Xinyuan-LilyGO/T-Display-S3-Pro-MVSRBoard/README.md

<!--
 * @Description: None
 * @Author: LILYGO_L
 * @Date: 2023-09-11 16:13:14
 * @LastEditTime: 2025-02-14 14:40:34
 * @License: GPL 3.0
-->
<h1 align = "center">T-Display-S3-Pro-MVSRBoard</h1>

## **English | [中文](./README_CN.md)**

## VersionIteration:
| Version | Update date |Update description|
| :---: | :---: |:---: |
| T-Display-S3-Pro-MVSRBoard_V1.0 | 2024-09-13 | Original version |
| T-Display-S3-Pro-MVSRBoard_V1.1 | 2024-12-03 | Replace microphone model |

## PurchaseLink

| Product | SOC |  FLASH  |  PSRAM | Link |
| :---: | :---: |:---: | :---: | :---: |
| T-Display-S3-Pro-MVSRBoard_V1.0 | NULL | NULL | NULL |  [NULL]() |

## Directory
- [Describe](#describe)
- [Preview](#preview)
- [Module](#module)
- [SoftwareDeployment](#SoftwareDeployment)
- [PinOverview](#pinoverview)
- [RelatedTests](#RelatedTests)
- [FAQ](#faq)
- [Project](#project)

## Describe

The T-Display-S3-Pro-MVSRBoard is the backplate design for the [T-Display-S3-Pro](https://github.com/Xinyuan-LilyGO/T-Display-S3-Pro) motherboard, featuring onboard speaker and microphone expansion with extremely low static current. Additionally, it includes vibration and RTC (Real-Time Clock) functions.

## Preview

### Actual Product Image

## Module

### 1. Speaker

* Chip: MAX98357A
* Bus communication protocol: IIS
* Other: Default using 9dB gain
* Related documentation: 
    >[MAX98357A](./information/MAX98357AETE+T.pdf)
* Dependent libraries: 
    >[Arduino_DriveBus-1.1.16]()

### 2. Microphone

> #### T-Display-S3-Pro-MVSRBoard_V1.0 version
> * Chip: MSM261S4030H0R
> * Bus communication protocol: IIS
> * Related documentation: 
>    >[MSM261S4030H0R](./information/MEMSensing-MSM261S4030H0R.pdf)
> * Dependent libraries: 
>     >[Arduino_DriveBus-1.1.16]()

> #### T-Display-S3-Pro-MVSRBoard_V1.1 version
> * Chip: MP34DT05-A
> * Bus communication protocol: PDM
> * Related documentation: 
>    >[MP34DT05-A](./information/mp34dt05-a.pdf)
> * Dependent libraries: 
>    >[Arduino_DriveBus-1.1.16]()

### 3. Vibration

* Bus communication protocol: PWM

### 4. RTC

* Chip: PCF85063ATL
* Bus communication protocol: IIC
* Related documentation: 
    >[PCF85063ATL](./information/PCF85063ATL-1,118.pdf)
* Dependent libraries: 
    >[Arduino_DriveBus-1.1.16]()

## SoftwareDeployment

### Examples Support

| Example | `[Platformio IDE][espressif32-v6.5.0]`<br />`[Arduino IDE][esp32_v2.0.14]` | Description | Picture |
| ---  | --- | --- | --- |
| [CST226SE](./examples/CST226SE) |  <p align="center"> | | |
| [Deep_Sleep_Wake_Up](./examples/Deep_Sleep_Wake_Up) |  <p align="center"> | | |
| [DMIC_ReadData](./examples/DMIC_ReadData) |  <p align="center"> | | |
| [DMIC_SD](./examples/DMIC_SD) |  <p align="center"> | | |
| [Get_HTTP_Response_Time](./examples/Get_HTTP_Response_Time) |  <p align="center"> | | |
| [GFX](./examples/GFX) |  <p align="center"> | | |
| [IIC_Scan_2](./examples/IIC_Scan_2) |  <p align="center"> | | |
| [Original_Test](./examples/Original_Test) |  <p align="center"> | Original factory program | |
| [PCF85063](./examples/PCF85063) |  <p align="center"> | | |
| [PCF85063_Scheduled_INT](./examples/PCF85063_Scheduled_INT) |  <p align="center"> | | |
| [PCF85063_Timer_INT](./examples/PCF85063_Timer_INT) |  <p align="center"> | | |
| [RT9080](./examples/RT9080) |  <p align="center"> | | |
| [SD_Explorer_Music](./examples/SD_Explorer_Music) |  <p align="center"> | | |
| [SD_Music](./examples/SD_Music) |  <p align="center"> | | |
| [SY6970](./examples/SY6970) |  <p align="center"> | | |
| [SY6970_OTG](./examples/SY6970_OTG) |  <p align="center"> | | |
| [USB_Host_Camera_Screen](./examples/USB_Host_Camera_Screen) |  <p align="center"> | | |
| [Vibration_Motor](./examples/Vibration_Motor) |  <p align="center"> | | |
| [WIFI_HTTP_Download_File](./examples/WIFI_HTTP_Download_File) |  <p align="center"> | | |
| [WIFI_HTTP_Download_SD_file](./examples/WIFI_HTTP_Download_SD_file) |  <p align="center"> | | |
| [Wifi_Music](./examples/Wifi_Music) |  <p align="center"> | | |

[supported]: https://img.shields.io/badge/-supported-green "example"

| Firmware | Description | Picture |
| ---  | ---  | --- |
| [Original_Test(T-Display-S3-Pro-MVSRBoard_V1.0)](./firmware/[T-Display-S3-Pro-MVSRBoard_V1.0][Original_Test]_firmware_V1.0.1.bin) | Original factory program |  |
| [Original_Test(T-Display-S3-Pro-MVSRBoard_V1.1)](./firmware/(麦克风数据字体颜色从白色改成蓝色)[T-Display-S3-Pro-MVSRBoard_V1.1][Original_Test]_firmware_202412261832.bin) | Original factory program |  |

### PlatformIO
1. Install [VisualStudioCode](https://code.visualstudio.com/Download) ,Choose installation based on your system type.

2. Open the "Extension" section of the Visual Studio Code software sidebar(Alternatively, use "<kbd>Ctrl</kbd>+<kbd>Shift</kbd>+<kbd>X</kbd>" to open the extension),Search for the "PlatformIO IDE" extension and download it.

3. During the installation of the extension, you can go to GitHub to download the program. You can download the main branch by clicking on the "<> Code" with green text, or you can download the program versions from the "Releases" section in the sidebar.

4. After the installation of the extension is completed, open the Explorer in the sidebar(Alternatively, use "<kbd>Ctrl</kbd>+<kbd>Shift</kbd>+<kbd>E</kbd>" go open it),Click on "Open Folder," locate the project code you just downloaded (the entire folder), and click "Add." At this point, the project files will be added to your workspace.

5. Open the "platformio.ini" file in the project folder (PlatformIO will automatically open the "platformio.ini" file corresponding to the added folder). Under the "[platformio]" section, uncomment and select the example program you want to burn (it should start with "default_envs = xxx") Then click "<kbd>[√](image/4.png)</kbd>" in the bottom left corner to compile,If the compilation is correct, connect the microcontroller to the computer and click "<kbd>[→](image/5.png)</kbd>" in the bottom left corner to download the program.

### Arduino
1. Install [Arduino](https://www.arduino.cc/en/software) ,Choose installation based on your system type.

2. Open the "example" directory within the project folder, select the example project folder, and open the file ending with ".ino" to open the Arduino IDE project workspace.

3. Open the "Tools" menu at the top right -> Select "Board" -> "Board Manager." Find or search for "esp32" and download the board files from the author named "Espressif Systems." Then, go back to the "Board" menu and select the development board type under "ESP32 Arduino." The selected development board type should match the one specified in the "platformio.ini" file under the [env] section with the header "board = xxx." If there is no corresponding development board, you may need to manually add the development board from the "board" directory within your project folder.

4. Open menu bar "[File](image/6.png)" -> "[Preferences](image/6.png)" ,Find "[Sketchbook location](image/7.png)"  here,copy and paste all library files and folders from the "libraries" folder in the project directory into the "libraries" folder in this directory.

5. Select the correct settings in the Tools menu, as shown in the table below.

#### ESP32-S3
| Setting | Value |
| :---: | :---: |
| Board | ESP32S3 Dev Module |
| Upload Speed | 921600 |
| USB Mode | Hardware CDC and JTAG |
| USB CDC On Boot | Enabled |
| USB Firmware MSC On Boot | Disabled |
| USB DFU On Boot | Disabled |
| CPU Frequency | 240MHz (WiFi) |
| Flash Mode | QIO 80MHz |
| Flash Size | 16MB (128Mb) |
| Core Debug Level | None |
| Partition Scheme | 16M Flash (3MB APP/9.9MB FATFS) |
| PSRAM | OPI PSRAM |
| Arduino Runs On | Core 1 |
| Events Run On | Core 1 | 

6. Select the correct port.

7. Click "<kbd>[√](image/8.png)</kbd>" in the upper right corner to compile,If the compilation is correct, connect the microcontroller to the computer,Click "<kbd>[→](image/9.png)</kbd>" in the upper right corner to download.

### firmware download
1. Open the project file "tools" and locate the ESP32 burning tool. Open it.

2. Select the correct burning chip and burning method, then click "OK." As shown in the picture, follow steps 1->2->3->4->5 to burn the program. If the burning is not successful, press and hold the "BOOT-0" button and then download and burn again.

3. Burn the file in the root directory of the project file "[firmware](./firmware/)" file,There is a description of the firmware file version inside, just choose the appropriate version to download.

<p align="center" width="100%">
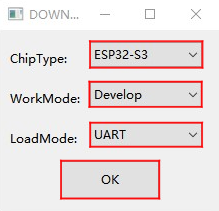
[picture p1: image/10.png]
    
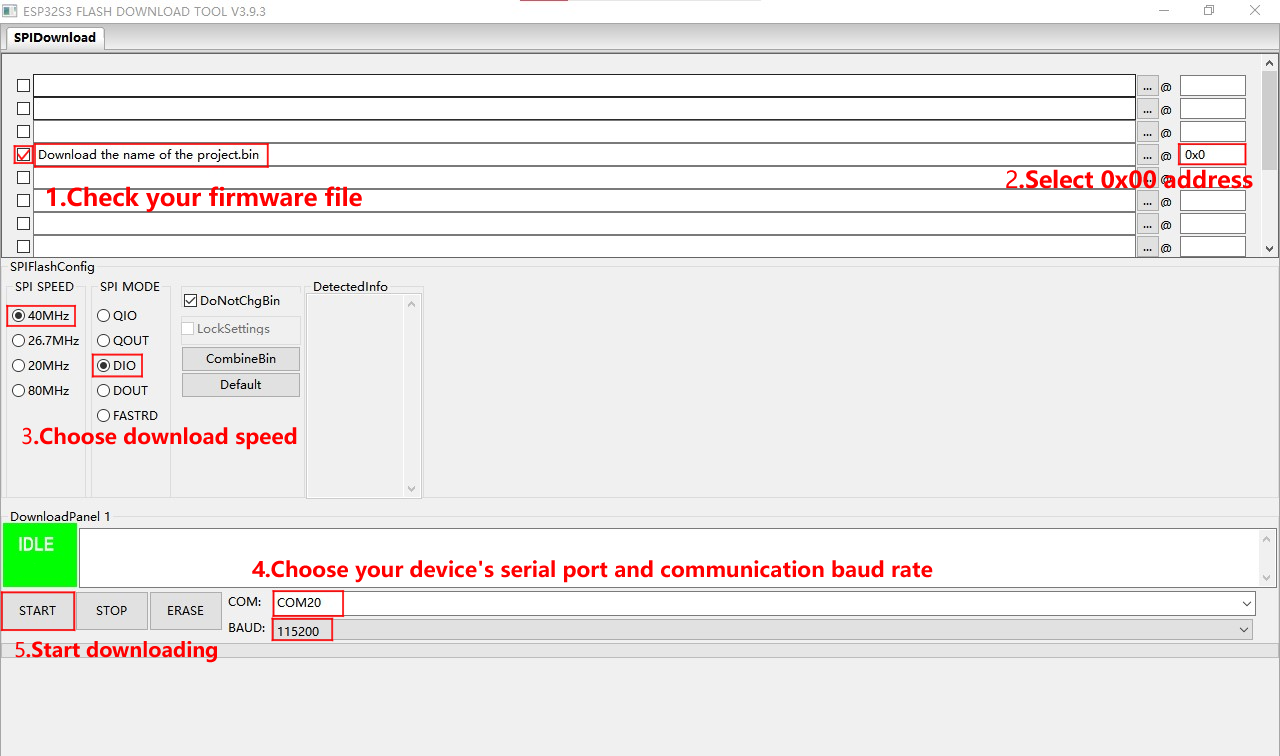
[picture p2: image/11.png]
    
</p>

## PinOverview

| Speaker pins  | ESP32S3 pins|
| :---: | :---:|
| BCLK | IO4 |
| LRCLK | IO15 |
| DATA | IO11 |
| SD_MODE | IO41 |

> #### T-Display-S3-Pro-MVSRBoard_V1.0 version
> | Microphone pins  | ESP32S3 pins|
> | :------------------: | :------------------:|
> | BCLK         | IO1       |
> | WS         | IO10       |
> | DATA         | IO2       |
> | EN         | IO3       |

> #### T-Display-S3-Pro-MVSRBoard_V1.1 version
> | Microphone pins  | ESP32S3 pins|
> | :------------------: | :------------------:|
> | LRCLK         | IO1       |
> | DATA         | IO2       |
> | EN         | IO3       |

| Vibration motor pins  | ESP32S3 pins|
| :---: | :---:|
| DATA | IO45 |

| RT9080 power pins  | ESP32S3 pins|
| :---: | :---:|
| EN | IO42 |

| RTC pins  | ESP32S3 pins|
| :---: | :---:|
| SDA | IO5 |
| SCL | IO6 |
| INT | IO7 |

## RelatedTests

### Power Dissipation
| Firmware | Program| Description | Picture |
| ---  | ---  | --- | --- |
| [Deep_Sleep_Wake_Up](./firmware/[T-Display-S3-Pro-MVSRBoard_V1.0-V1.1][Deep_Sleep_Wake_Up]_firmware_202502051632.bin) | [Deep_Sleep_Wake_Up](./examples/Deep_Sleep_Wake_Up) | Static current: 1.22 μA for more information please refer to [Power Consumption Test Log](./relevant_test/PowerConsumptionTestLog_[T-Display-S3-Pro-MVSRBoard_V1.1]_20241210.pdf) | |

## FAQ

* Q. After reading the above tutorials, I still don't know how to build a programming environment. What should I do?
* A. If you still don't understand how to build an environment after reading the above tutorials, you can refer to the [LilyGo-Document](https://github.com/Xinyuan-LilyGO/LilyGo-Document) document instructions to build it.

<br />

* Q. Why does Arduino IDE prompt me to update library files when I open it? Should I update them or not?
* A. Choose not to update library files. Different versions of library files may not be mutually compatible, so it is not recommended to update library files.

<br />

* Q. Why is there no serial data output on the "Uart" interface on my board? Is it defective and unusable?
* A. The default project configuration uses the USB interface as Uart0 serial output for debugging purposes. The "Uart" interface is connected to Uart0, so it won't output any data without configuration.<br />For PlatformIO users, please open the project file "platformio.ini" and modify the option under "build_flags = xxx" from "-D ARDUINO_USB_CDC_ON_BOOT=true" to "-D ARDUINO_USB_CDC_ON_BOOT=false" to enable external "Uart" interface.<br />For Arduino users, open the "Tools" menu and select "USB CDC On Boot: Disabled" to enable the external "Uart" interface.

<br />

* Q. Why is my board continuously failing to download the program?
* A. Please hold down the "BOOT-0" button and try downloading the program again.

## Project
* [T-Display-S3-Pro-MVSRBoard_V1.0](./project/T-Display-S3-Pro-MVSRBoard_V1.0.pdf)
* [T-Display-S3-Pro-MVSRBoard_V1.1](./project/T-Display-S3-Pro-MVSRBoard_V1.1.pdf)
