Xinyuan-LilyGO/T-Display-S3-Pro-MVSRBoard/project/T-Display-S3-Pro-MVSRBoard_V1.1.pdf

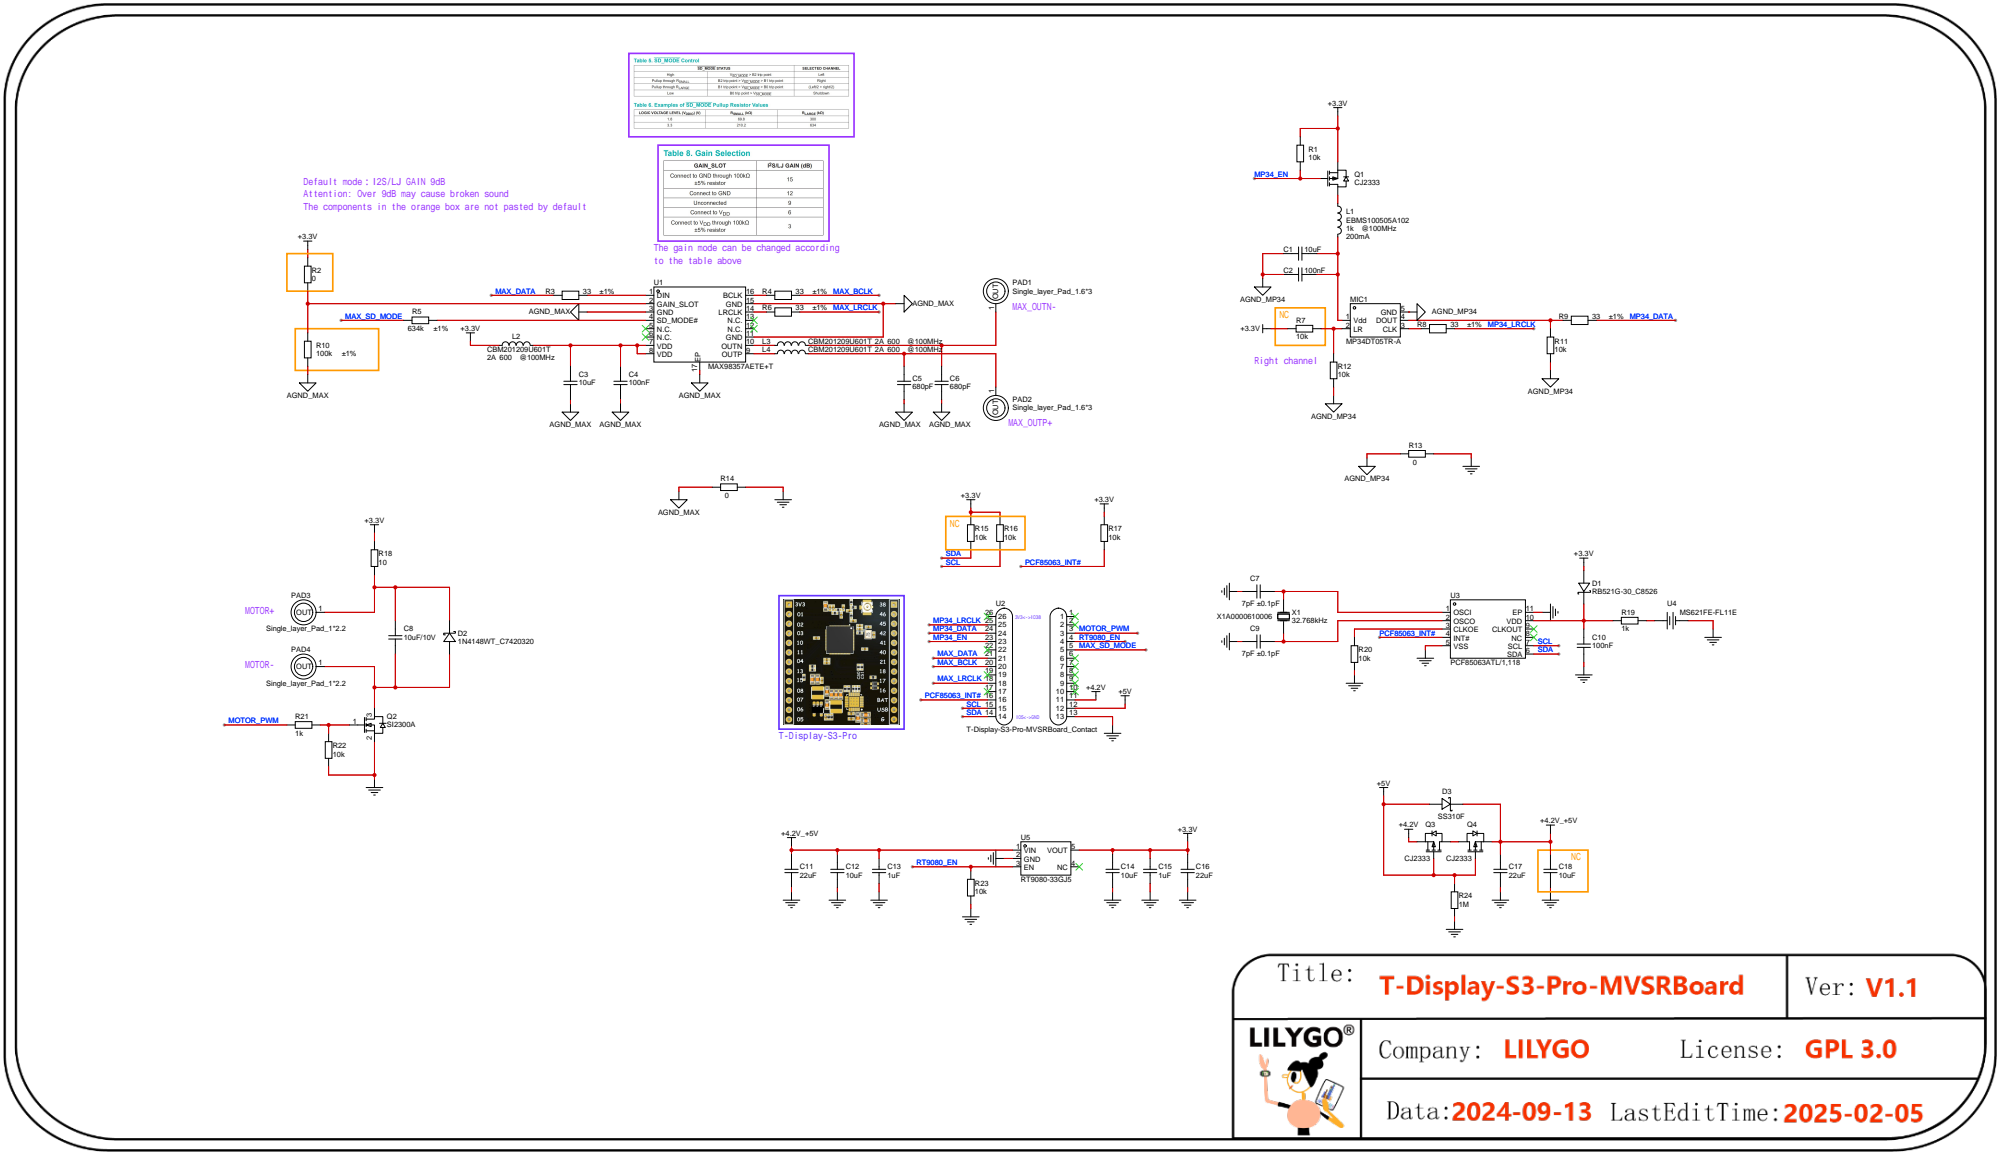
[picture p10: page 1]

Default mode：I2S/LJ GAIN 9dB
Attention: Over 9dB may cause broken sound
The components in the orange box are not pasted by default

The gain mode can be changed according
to the table above

OUTN 10 GND 11 N.C. 12 N.C. 13 LRCLK 14 GND 15 BCLK 16
