Xinyuan-LilyGO/T-Display-S3-Pro-MVSRBoard/project/T-Display-S3-Pro-MVSRBoard_V1.0.pdf

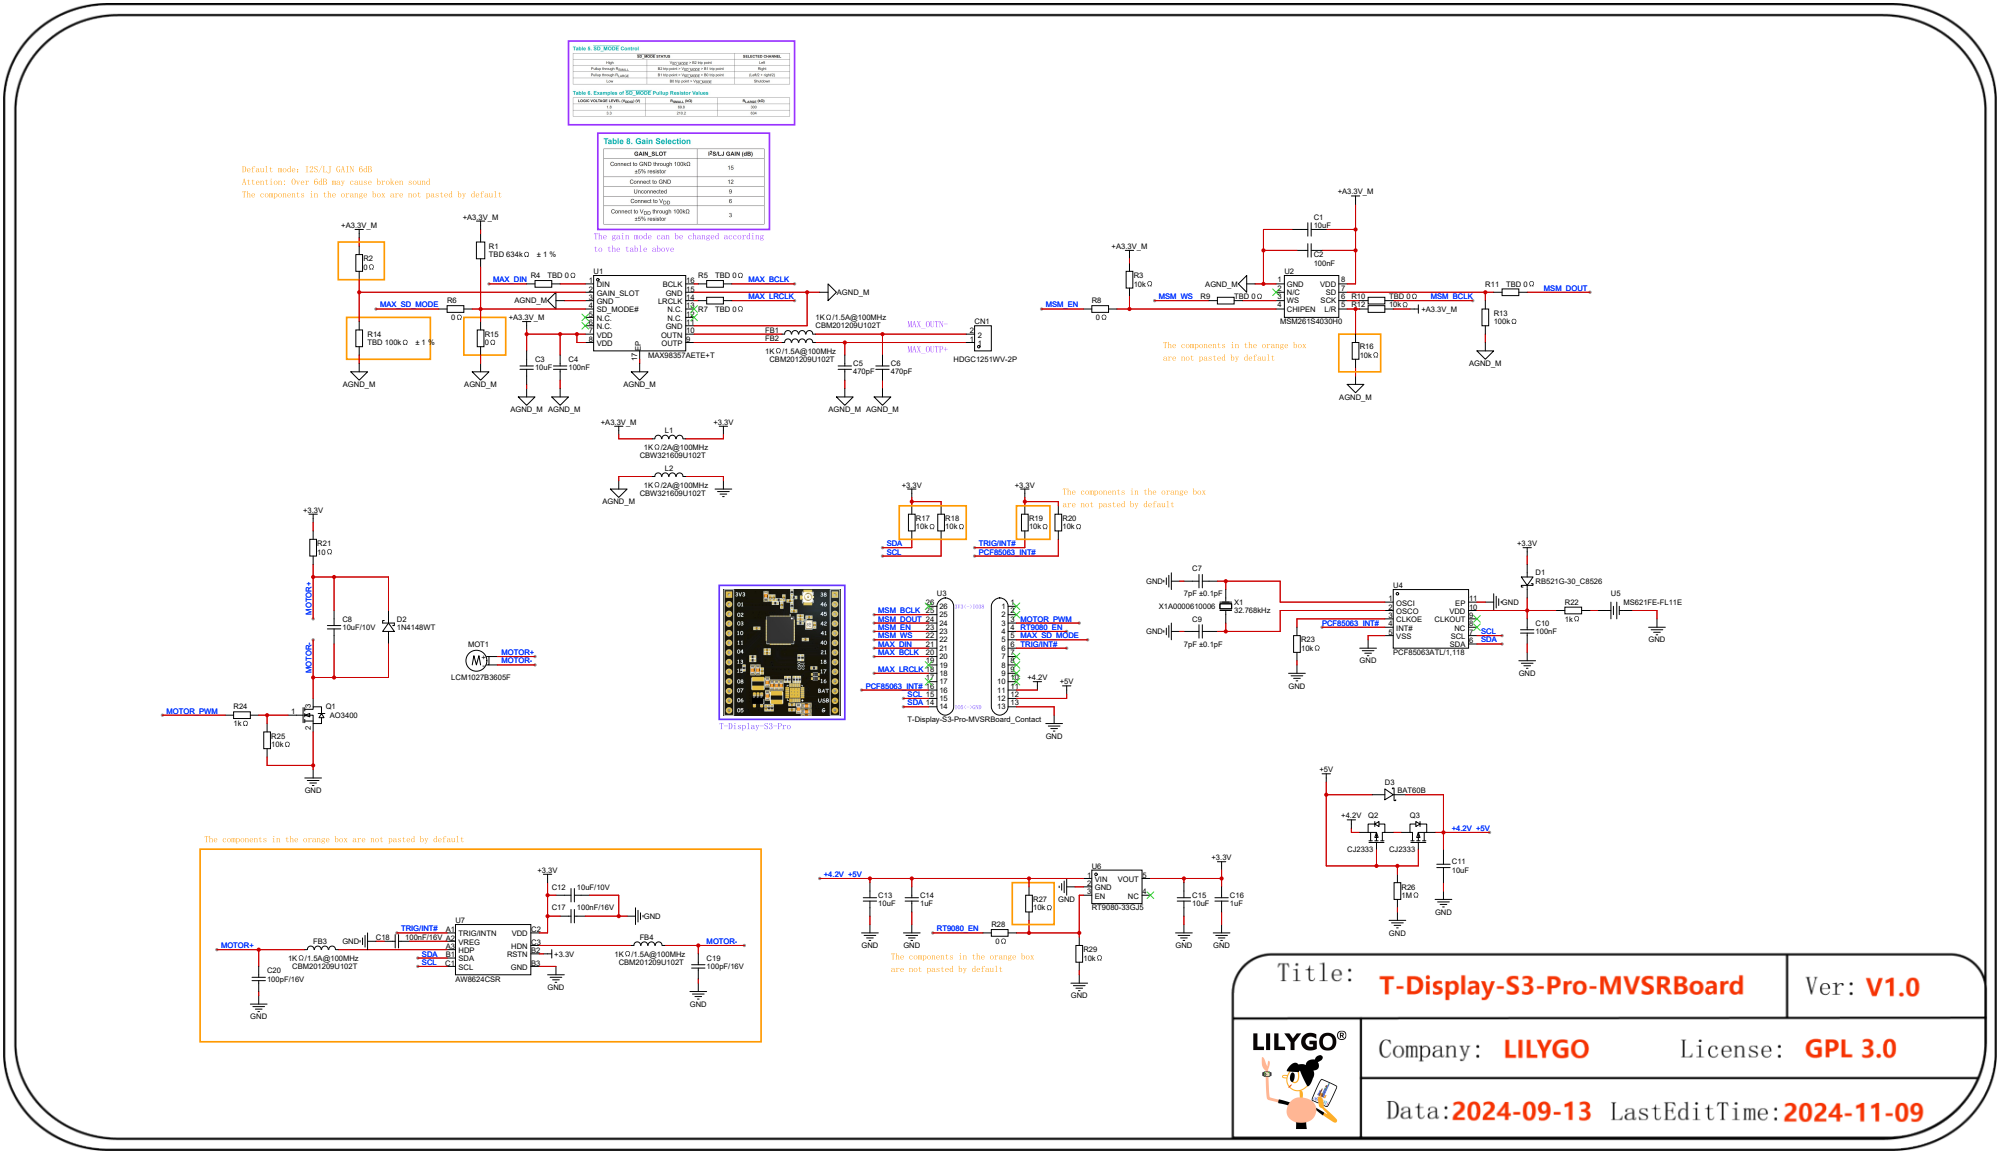
[picture p11: page 1]

SDA 6 SCL 7 NC 8 CLKOUT 9 VDD 10 EP 11
