Xinyuan-LilyGO/T-Display-S3-Pro-MVSRBoard/examples/CST226SE/CST226SE.ino

/*
 * @Description: Touch test
 * @Author: LILYGO_L
 * @Date: 2024-11-07 10:02:24
 * @LastEditTime: 2025-02-05 13:57:17
 * @License: GPL 3.0
 */
#include "Arduino_DriveBus_Library.h"
#include "pin_config.h"

static size_t CycleTime = 0;

std::shared_ptr<Arduino_IIC_DriveBus> IIC_Bus =
    std::make_shared<Arduino_HWIIC>(IIC_SDA, IIC_SCL, &Wire);

void Arduino_IIC_Touch_Interrupt(void);

std::unique_ptr<Arduino_IIC> CST226SE(new Arduino_CST2xxSE(IIC_Bus, CST226SE_DEVICE_ADDRESS,
                                                           TOUCH_RST, TOUCH_INT, Arduino_IIC_Touch_Interrupt));

void Arduino_IIC_Touch_Interrupt(void)
{
    CST226SE->IIC_Interrupt_Flag = true;
}

void setup()
{
    Serial.begin(115200);
    Serial.println("Ciallo");

    while (CST226SE->begin() == false)
    {
        Serial.println("CST226SE initialization fail");
        delay(2000);
    }
    Serial.println("CST226SE initialization successfully");

    // 目前休眠功能只能进入不能退出 要退出只能系统重置
    // CST226SE->IIC_Write_Device_State(CST226SE->Arduino_IIC_Touch::Device::TOUCH_DEVICE_SLEEP_MODE,
    //                                 CST226SE->Arduino_IIC_Touch::Device_State::TOUCH_DEVICE_ON);

    Serial.printf("ID: %#X \n\n", (int32_t)CST226SE->IIC_Device_ID());
    delay(1000);
}

void loop()
{
    Serial.printf("System running time: %d\n\n", (uint32_t)millis() / 1000);

    if (CST226SE->IIC_Interrupt_Flag == true)
    {
        CST226SE->IIC_Interrupt_Flag = false;

        Serial.printf("ID: %#X \n\n", (int32_t)CST226SE->IIC_Device_ID());

        Serial.printf("Fingers Number:%d\n",
                      (int32_t)CST226SE->IIC_Read_Device_Value(CST226SE->Arduino_IIC_Touch::Value_Information::TOUCH_FINGER_NUMBER));
        Serial.printf("Touch X:%d Y:%d\n",
                      (int32_t)CST226SE->IIC_Read_Device_Value(CST226SE->Arduino_IIC_Touch::Value_Information::TOUCH_COORDINATE_X),
                      (int32_t)CST226SE->IIC_Read_Device_Value(CST226SE->Arduino_IIC_Touch::Value_Information::TOUCH_COORDINATE_Y));

        Serial.printf("\nTouch X1:%d Y1:%d\n",
                      (int32_t)CST226SE->IIC_Read_Device_Value(CST226SE->Arduino_IIC_Touch::Value_Information::TOUCH1_COORDINATE_X),
                      (int32_t)CST226SE->IIC_Read_Device_Value(CST226SE->Arduino_IIC_Touch::Value_Information::TOUCH1_COORDINATE_Y));
        Serial.printf("Touch X2:%d Y2:%d\n",
                      (int32_t)CST226SE->IIC_Read_Device_Value(CST226SE->Arduino_IIC_Touch::Value_Information::TOUCH2_COORDINATE_X),
                      (int32_t)CST226SE->IIC_Read_Device_Value(CST226SE->Arduino_IIC_Touch::Value_Information::TOUCH2_COORDINATE_Y));
        Serial.printf("Touch X3:%d Y3:%d\n",
                      (int32_t)CST226SE->IIC_Read_Device_Value(CST226SE->Arduino_IIC_Touch::Value_Information::TOUCH3_COORDINATE_X),
                      (int32_t)CST226SE->IIC_Read_Device_Value(CST226SE->Arduino_IIC_Touch::Value_Information::TOUCH3_COORDINATE_Y));
        Serial.printf("Touch X4:%d Y4:%d\n",
                      (int32_t)CST226SE->IIC_Read_Device_Value(CST226SE->Arduino_IIC_Touch::Value_Information::TOUCH4_COORDINATE_X),
                      (int32_t)CST226SE->IIC_Read_Device_Value(CST226SE->Arduino_IIC_Touch::Value_Information::TOUCH4_COORDINATE_Y));
        Serial.printf("Touch X5:%d Y5:%d\n",
                      (int32_t)CST226SE->IIC_Read_Device_Value(CST226SE->Arduino_IIC_Touch::Value_Information::TOUCH5_COORDINATE_X),
                      (int32_t)CST226SE->IIC_Read_Device_Value(CST226SE->Arduino_IIC_Touch::Value_Information::TOUCH5_COORDINATE_Y));

        Serial.printf("\nTouch1 Pressure Value:%d\n",
                      (int32_t)CST226SE->IIC_Read_Device_Value(CST226SE->Arduino_IIC_Touch::Value_Information::TOUCH1_PRESSURE_VALUE));
        Serial.printf("Touch2 Pressure Value:%d\n",
                      (int32_t)CST226SE->IIC_Read_Device_Value(CST226SE->Arduino_IIC_Touch::Value_Information::TOUCH2_PRESSURE_VALUE));
        Serial.printf("Touch3 Pressure Value:%d\n",
                      (int32_t)CST226SE->IIC_Read_Device_Value(CST226SE->Arduino_IIC_Touch::Value_Information::TOUCH3_PRESSURE_VALUE));
        Serial.printf("Touch4 Pressure Value:%d\n",
                      (int32_t)CST226SE->IIC_Read_Device_Value(CST226SE->Arduino_IIC_Touch::Value_Information::TOUCH4_PRESSURE_VALUE));
        Serial.printf("Touch5 Pressure Value:%d\n",
                      (int32_t)CST226SE->IIC_Read_Device_Value(CST226SE->Arduino_IIC_Touch::Value_Information::TOUCH5_PRESSURE_VALUE));
    }

    delay(500);

    if (millis() > CycleTime)
    {
        CycleTime = millis() + 5000;
    }
}
